R-Mutura/the_hub/README.md

# the_hub
intricate design with USB hub PD charger and M.2 connector
