R-Mutura/the_hub/BOM/BOM.xlsx

REFERENCE | VALUE | FOOTPRINT | MANUFUCTURER PART NO | VENDOR | LINKS | QTY | PRICE/ PIECE | TOTAL
> C1-C7, C20-C22, C25, C26, C28-C30, C32, C33, C45-C48, C54, C55, C58-C64, C67, C68, C70, C72-C76, C93-C95, C102-C114, C120-C123, C129-C133, C135-C155, C189, C194, C196, C197, C201 | 0.1uF | Capacitor_SMD:C_0402_1005Metric | 0402B104K6R3CT | LCSC |  | 89 | 0.0017 | 0.1513
> C8-C11, C13, C15, C17, C19, C34, C35, C56, C192, C193, C202 | 10uF | Capacitor_SMD:C_0603_1608Metric | CL10A106MQ8NNNC | LCSC |  | 14 | 0.0017 | 0.0238
C161 | 10uF | Capacitor_SMD:C_0603_1608Metric | GRM188R6YA106MA73D | LCSC |  | 1 | 0.0596 | 0.0596
> C12, C14, C16, C18, C159 | 100nF | Capacitor_SMD:C_0402_1005Metric | 0402B104K6R3CT | LCSC |  | 5 | 0.0017 | 0.0085
> C23, C24, C36, C37, C52, C53, C127, C128 | 22pF | Capacitor_SMD:C_0402_1005Metric | CC0402JRNPO9BN220 | LCSC |  | 8 | 0.0017 | 0.0136
C31 | 2.2uF | Capacitor_SMD:C_0402_1005Metric | EMK105ABJ225KV-F | LCSC |  | 1 | 0.0017 | 0.0017
> C38, C39, C44, C50, C119, C125 | 4.7uF | Capacitor_SMD:C_0603_1608Metric | CL10A475KQ8NNNC | LCSC |  | 6 | 0.0017 | 0.0102
> C40, C41, C115, C116 | 18pF | Capacitor_SMD:C_0402_1005Metric | 0402CG180J500NT | LCSC |  | 4 | 0.0017 | 0.0068
> C42, C117 | 1uF_1%_0.1ohm | Capacitor_SMD:C_0603_1608Metric | CC0603JRX7R7BB105 | LCSC |  | 2 | 0.0017 | 0.0034
> C43, C118 | 1uF | Capacitor_SMD:C_0603_1608Metric | CC0603JRX7R7BB105 | LCSC |  | 2 | 0.0017
> C49, C51, C124, C126, C162 | 1nF | Capacitor_SMD:C_0402_1005Metric | 0402B102J500CT | LCSC |  | 5 | 0.0017 | 0.0085
> C57, C65, C66, C69, C71, C81, C100, C134, C163, C177, C178, C186, C187 | 1uF | Capacitor_SMD:C_0402_1005Metric | CL05A105KQ5NNNC | LCSC |  | 14 | 0.0017 | 0.0238
C184 | 1uF | Capacitor_SMD:C_0402_1005Metric | CL05A105KA5NQNC | LCSC |  | 1 | 0.0017 | 0.0017
> C77, C78 | 1nF_2KV | Capacitor_SMD:C_1206_3216Metric | 1206B102K202NT | LCSC |  | 2 | 0.0017 | 0.0034
> C80, C84 | 12pF | Capacitor_SMD:C_0402_1005Metric | 0402CG120J500NT | LCSC |  | 2 | 0.0017 | 0.0034
> C79, C82, C83, C85-C92, C96-C99 | 0.01uF | Capacitor_SMD:C_0402_1005Metric | CC0402KRX7R9BB103 | LCSC |  | 15 | 0.0017 | 0.0255
C101 | 22uF | Capacitor_SMD:C_0402_1005Metric | GRM155R60J226ME11D | LCSC |  | 1 | 0.0017 | 0.0017
> C156, C158, C160 | 1uF_GRT155C81E105KE13_402 | Capacitor_SMD:C_0402_1005Metric | CL05A105KA5NQNC | LCSC |  | 3 | 0.0017 | 0.0051
C157 | 220uF | Capacitor_SMD:CP_Elec_10x10 | UWT1H221MNL1GS | LCSC |  | 1 | 0.0017 | 0.0017
C164 | 2.2uF(1mOHM) | Capacitor_SMD:C_0402_1005Metric | C1005X5R1E225KT000E | LCSC |  | 1 | 0.0017 | 0.0017
C165 | 22nF | Capacitor_SMD:C_0402_1005Metric | C1005X5R1E225KT000E | LCSC |  | 1 | 0.0017 | 0.0017
C166 | 4.7uF | Capacitor_SMD:C_0402_1005Metric | GRM155R60J475ME87D | LCSC |  | 1 | 0.0017 | 0.0017
C167 | 15nF | Capacitor_SMD:C_0402_1005Metric | CC0402KRX7R9BB153 | LCSC |  | 1 | 0.0017 | 0.0017
C168 | 10pF | Capacitor_SMD:C_0402_1005Metric | CC0402JRNPO9BN100 | LCSC |  | 1 | 0.0017 | 0.0017
C169 | 120Pf_1mOHM | Capacitor_SMD:C_0402_1005Metric | 0402CG121J500NT | LCSC |  | 1 | 0.0017 | 0.0017
C170 | 470nF(0.mOHM) | Capacitor_SMD:C_0402_1005Metric | CL05A474KP5NNNC | LCSC |  | 1 | 0.0017 | 0.0017
> C171, C173 | 270uF(8mOHM) | Capacitor_SMD:CP_Elec_6.3x7.7 | 16SVPG270M | LCSC |  | 2 | 0.0017 | 0.0034
C172 | 10uF_1mOHM_402 | Capacitor_SMD:C_0402_1005Metric | GRM155R60G106ME44D | LCSC |  | 1 | 0.0017 | 0.0017
C174 | 56pF(1.mOHM) | Capacitor_SMD:C_0402_1005Metric | C1005C0G1H560J050BA | Digikey(DK) |  | 1 | 0.0017 | 0.0017
> C175, C198, C199, C200 | 220uF | Capacitor_SMD:CP_Elec_5x5.9 | 6SVPE220MW | LCSC |  | 4 | 0.0017 | 0.0068
C176 | 1uF_50V | Capacitor_SMD:C_0402_1005Metric | CL05A105KA5NQNC | LCSC |  | 1 | 0.0017 | 0.0017
> C179, C182 | 0.1uF_25V | Capacitor_SMD:C_0402_1005Metric | GMC04X7R104K25NT | Digikey(DK) |  | 2 | 0.0017 | 0.0034
> C180, C181 | 22uF | Capacitor_SMD:C_0805_2012Metric | CL21A226MAQNNNE | LCSC |  | 2 | 0.0017 | 0.0034
C183 | 1nF>25v | Capacitor_SMD:C_0402_1005Metric | CC0402KRX7R9BB102 | LCSC |  | 1 | 0.0017 | 0.0017
> C185, C188 | 100pF | Capacitor_SMD:C_0402_1005Metric | 0402CG101J500NT | LCSC |  | 2 | 0.0017 | 0.0034
> C190, C191 | 4.7uF | Capacitor_Tantalum_SMD:CP_EIA-3528-21_Kemet-B | CA45-B-35V-4.7UF-K | LCSC |  | 2 | 0.0017 | 0.0034
C195 | 10uF | Capacitor_SMD:C_0402_1005Metric | CL05A106MP5NUNC | LCSC |  | 1 | 0.0017 | 0.0017
> C27, C203 | 0.1uf | Capacitor_SMD:C_0402_1005Metric | 0402B104K6R3CT | LCSC |  | 2 | 0.0017 | 0.0034
> D1-D6, D10-D14, D17-D22, D33-D35 | ESD122DMXR | SamacSys_Parts_2:DMX0003A | ESD122DMXR | Mouser/lcsc |  | 20 | 0.2474 | 4.948
> D7-D9 | D | Diode_SMD:D_SOD-323 | B5817WS | LCSC |  | 3 | 0.0242 | 0.0726
D23 | SSD_COM_ON_blue | LED_SMD:LED_0603_1608Metric | 19-217/BHC-ZL1M2RY/3T | LCSC |  | 1 | 0.0173 | 0.0173
D24 | STPS30L30DJF-TR | SamacSys_Parts_2:STPS30L30DJFTR | STPS30L30DJF-TR | DigiKey(DK) |  | 1 | 1.38 | 1.38
D26 | SSB44-E3/52T | Diode_SMD:D_SMB | SSB44-E3/52T | LCSC |  | 1 | 0.3795 | 0.3795
> D25, D27, D32 | ESDA25P35 | digikey-footprints:SOD-523 | ESDA25P35 | LCSC |  | 3 | 0.3082 | 0.9246
D28 | SBR10B45P5-13 | Diode_SMD:D_PowerDI-5 | SBR10B45P5-13 | LCSC |  | 1 | 0.55 | 0.55
> D29-D31 | SMAJ30A | Diode_SMD:D_SMA | SMAJ30A | DigiKey |  | 3 | 0.07883 | 0.23649
> FB1, FB2 | Ferrite Bead | Inductor_SMD:L_0603_1608Metric | HCB1608KF-391T10 | LCSC |  | 2 | 0.0045 | 0.009
HDMI1 | HDMI-SWM-19 | OLIMEX_Connectors-FP:HDMI-SWM-19 | HDMI-019S | LCSC |  | 1 | 0.3284 | 0.3284
IC1 | TUSB2046BIRHBT | SamacSys_Parts_2:QFN50P500X500X100-33N-D | TUSB2046BIRHBT | DigiKey |  | 1 | 4.96 | 4.96
> IC2, IC3 | USB2240-AEZG-06 | SamacSys_Parts_2:QFN50P600X600X100-37N-D | USB2240-AEZG-06 | Microchip | https://www.microchipdirect.com/product/search/all/USB2240 | 2 | 2.28 | 4.56
IC4 | TPS62824ADMQR | SamacSys_Parts_2:TPS62824ADMQR | TPS62824ADMQR | DigiPart | http://www.sierraic.com/TPS62824ADMQR | 1 |  | 0
IC5 | STUSB4700YQTR | SamacSys_Parts_2:QFN50P400X400X100-25N | STUSB4700YQTR | DigiPart | https://www.hkchipsource.com/chips/stmicroelectronics/STUSB4700QTR.html | 1 |  | 0
IC6 | ADAU1961WBCPZ-R7 | SamacSys_Parts_2:QFN50P500X500X100-33N-D | ADAU1961WBCPZ-R7 | DigiPart | https://www.hkchipsource.com/chips/analog-devices/ADAU1961WBCPZ-R7.html | 1 |  | 0
J1 | USB_C_Receptacle | Connector_USB:USB_C_Receptacle_Amphenol_12401610E4-2A | U262-241N-4BV64 | LCSC |  | 1 | 0.5194 | 0.5194
> J2, J3 | USB3_A | footprints:USB_A_3.1_GCT_USB1075-XX-X-X_REVE | 901-112A105AD10100 | LCSC |  | 2 | 0.2273 | 0.4546
J4 | USB_C_Receptacle | footprints:usb_C_MOLEX_105450-0101 | U262-241N-4BV64 | LCSC |  | 1 | 0.5194 | 0.5194
J5 | Micro_SD_Card_Det | footprints:GCT_MEM2051-00-195-00-A | MEM2051-00-195-00-A | DigiKey |  | 1 | $0.69 | 0.69048
J6 | RJ45_Shielded | footprints:CONN_RJ45-8Z | DS1128-05-S8B8P | LCSC | https://lcsc.com/product-detail/Ethernet-Connectors-Modular-Connectors-span-style-background-color-ff0-RJ45-span-RJ11_CONNFLY-Elec-DS1128-05-S8B8P_C86577.html | 1 | 0.2525 | 0.2525
J7 | Bus_M.2_Socket_M | footprints:TE_1-2199119-3 | SM3ZS067U310AMR1200 | DigiKey | https://www.digikey.com/en/products/detail/jae-electronics/SM3ZS067U310AMR1200/4162221 | 1 | 1.45 | 1.45
J8 | SD_Card | footprints:3M_SD-RSMT-2-MQ-WF | SD-RSMT-2-MQ-WF | DigiKey | https://www.digikey.com/en/products/detail/3m/SD-RSMT-2-MQ-WF/1616663 | 1 | 4.2 | 4.2
J9 | AudioJack2_Ground | footprints:CUI_SJ1-3533N | SJ1-3533NG | DigiKey | https://www.digikey.com/en/products/detail/cui-devices/SJ1-3533N/738698 | 1 | 1.23 | 1.23
J10 | USB_C_Receptacle_USB2.0 | footprints:GCT_USB4105_REVA | USB4105-GF-A | DigiKey | https://www.digikey.com/en/products/detail/gct/USB4105-GF-A/11198441 | 1 | 0.51083 | 0.51083
L1 | 3.3uH | SamacSys_Parts_2:INDPM4040X200N | 0840CDMCCDS-1R0MC | DigiKey | https://www.digikey.com/en/products/detail/sumida-america-components-inc/0840CDMCCDS-1R0MC/11682076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 | 1 | 1.64 | 1.64
L2 | 1uH_5.6mOHM. | footprints:0840CDMCCDS-1R0MC | SRP3012TA-R47M | DigiKey | https://www.digikey.com/en/products/detail/bourns-inc/SRP3012TA-R47M/9350988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 | 1 | 0.5294 | 0.5294
L3 | 470nH_30m | footprints:SRP3012TA-R47M | PM4548.102NLT | DigiKey | https://www.digikey.com/en/products/detail/pulse-electronics-power/PM4548-102NLT/10814970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 | 1 | 0.528 | 0.528
L4 | 4.5uH_13.5mOHM. | footprints:PM4548.102NLT | SRP1038A-100M | DigiKey |  | 1 | 0.8607 | 0.8607
L5 | SRP1038A-100M | SamacSys_Parts_2:INDPM110100X400N | SRP1038A-100M | DigiKey |  | 1 | 0.8607 | 0.8607
P1 | USB_C_Plug | footprints:USB_C_PLUG_GCT_USB4155-03-C_REVA | USB4155-03-C | Digikey | https://www.digikey.com/en/products/detail/gct/USB4155-03-C/14305161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 | 1 | 1.67 | 1.67
> Q1, Q2 | SI4842BDY-T1-GE3 | Package_TO_SOT_SMD:SuperSOT-8 | SI4842BDY-T1-GE3 | DigiKey | https://www.digikey.com/en/products/detail/vishay-siliconix/SI4842BDY-T1-GE3/1978857 | 2 | 2.33 | 4.66
Q3 | IRF3710ZSTRLPBF | Package_TO_SOT_THT:TO-220-3_Vertical | IRF3710ZSTRLPBF | DigiKey | https://www.digikey.com/en/products/detail/infineon-technologies/IRF3710ZSTRLPBF/1928270 | 1 | 1.95 | 1.95
Q4 | STL6P3LLH6 | footprints:TRANS_STL6P3LLH6 | STL6P3LLH6 | DigiPart | https://www.digipart.com/rfq?distr=Semisource&mfr=STM&mpn=STL6P3LLH6 | 1 |  | 0
> Q5, Q6, Q8, Q9 | BSH105,215 | Package_TO_SOT_SMD:SC-59 | BSH105,215 | LCSC | https://lcsc.com/product-detail/MOSFETs_Nexperia-BSH105-215_C478010.html | 4 | 0.21 | 0.84
Q7 | RQ5E025ATTCL | SamacSys_Parts_2:SOT95P280X100-3N | RQ5E025ATTCL | DigiKey | https://www.digikey.com/en/products/detail/rohm-semiconductor/RQ5E025ATTCL/6573259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 | 1 | 0.46 | 0.46
> R1, R21, R41 | 1K | Resistor_SMD:R_0402_1005Metric | 0402WGF1001TCE | LCSC |  | 3 | 0.0007 | 0.0021
> R2, R3, R15, R36 | 1M | Resistor_SMD:R_0402_1005Metric | 0402WGF1004TCE | LCSC |  | 4 | 0.0007 | 0.0028
> R4-R7 | 6.8K | Resistor_SMD:R_0603_1608Metric | 0402WGJ0222TCE | LCSC |  | 4 | 0.0006 | 0.0024
R8 | 2.2K_402 | Resistor_SMD:R_0402_1005Metric | 0402WGJ0222TCE | LCSC |  | 1 | 0.0025 | 0.0025
R9 | 100K | Resistor_SMD:R_0805_2012Metric | 0805W8F1003T5E | LCSC |  | 1 | 0.0242 | 0.0242
R10 | 249OHM/1% | Resistor_SMD:R_0603_1608Metric | ARG03BTC2489 | LCSC |  | 1 | 0.0242 | 0.0242
> R11-R13, R31-R35, R101 | 4.7K | Resistor_SMD:R_0402_1005Metric | 0402WGF4701TCE | LCSC |  | 9 | 0.0007 | 0.0063
> R14, R18-R20, R23, R39, R40, R42-R46, R50, R56, R98, R99 | 10K | Resistor_SMD:R_0402_1005Metric | 0402WGF1002TCE | LCSC |  | 16 | 0.0007 | 0.0112
> R16, R37, R79-R81, R84, R89, R93, R96 | 100K | Resistor_SMD:R_0402_1005Metric | 0402WGF1003TCE | LCSC |  | 9 | 0.0007 | 0.0063
> R17, R22, R38 | 12K_1% | Resistor_SMD:R_0402_1005Metric | RTT021202FTH | LCSC |  | 3 | 0.0026 | 0.0078
R24 | 2K_1% | Resistor_SMD:R_0402_1005Metric | AC0402FR-072KL | LCSC |  | 1 | 0.0011 | 0.0011
> R25-R28 | 75 | Resistor_SMD:R_0402_1005Metric | ERJPA2J750X | LCSC |  | 4 | 0.0167 | 0.0668
R29 | 90.9K | Resistor_SMD:R_0402_1005Metric | 0402WGF9092TCE | LCSC |  | 1 | 0.0007 | 0.0007
R30 | 10K_1% | Resistor_SMD:R_0402_1005Metric | 0402WGF1002TCE | LCSC |  | 1 | 0.0007 | 0.0007
> R47, R48 | 200K | Resistor_SMD:R_0402_1005Metric | 0402WGF2003TCE | LCSC |  | 2 | 0.0007 | 0.0014
> R49, R51-R55 | 47K | Resistor_SMD:R_0402_1005Metric | RC0402FR-0747KL | LCSC |  | 6 | 0.0025 | 0.015
R57 | 12K | Resistor_SMD:R_0402_1005Metric | RTT021202FTH | LCSC |  | 1 | 0.0026 | 0.0026
R58 | 2.55K | Resistor_SMD:R_0603_1608Metric | RMC060325.5K1%N | LCSC |  | 1 | 0.0019 | 0.0019
R59 | 26.7K | Resistor_SMD:R_0603_1608Metric | 0603WAF2672T5E | LCSC |  | 1 | 0.0015 | 0.0015
R61 | 1.24K | Resistor_SMD:R_0603_1608Metric | 0603WAF1241T5E | LCSC |  | 1 | 0.0015 | 0.0015
R62 | 100 | Resistor_SMD:R_0603_1608Metric | MR06X1000FTL | LCSC |  | 1 | 0.0014 | 0.0014
> R63, R71, R75 | 1K | Resistor_SMD:R_0603_1608Metric | 0603WAF1001T5E | LCSC |  | 3 | 0.0012 | 0.0036
R64 | 2.94K | Resistor_SMD:R_0603_1608Metric | 0603WAF2941T5E | LCSC |  | 1 | 0.0016 | 0.0016
R65 | 6m | Resistor_SMD:R_0805_2012Metric | WSLP08056L000FEA18 | DigiKey |  | 1 | 1.03 | 1.03
R66 | 82.5K | Resistor_SMD:R_0603_1608Metric | CRCW060382K5FKEA | LCSC |  | 1 | 0.007 | 0.007
> R60, R67, R72, R76 | 100K | Resistor_SMD:R_0603_1608Metric | 0603WAJ0104T5E | LCSC |  | 4 | 0.0011 | 0.0044
R102 | 36.1K | Resistor_SMD:R_0603_1608Metric | TNPW040236K1BEED | DigiKey |  | 1 | 0.59 | 0.59
R68 | 10.2K | Resistor_SMD:R_0603_1608Metric | CR0603FA1022G | LCSC |  | 1 | 0.001 | 0.001
> R69, R87, R94 | 10K | Resistor_SMD:R_0603_1608Metric | 0603WAF1002T5E | LCSC |  | 3 | 0.0013 | 0.0039
R70 | 470 | Resistor_SMD:R_0603_1608Metric | HPCR0603F470RK9 | LCSC |  | 1 | 0.0335 | 0.0335
> R73, R74 | 22K | Resistor_SMD:R_0603_1608Metric | ERJP03J223V | LCSC |  | 2 | 0.0295 | 0.059
R77 | 11K | Resistor_SMD:R_0603_1608Metric | RTT031102FTP | LCSC |  | 1 | 0.0013 | 0.0013
R78 | 47.5K | Resistor_SMD:R_0603_1608Metric | 0603WAF4752T5E | LCSC |  | 1 | 0.0014 | 0.0014
R82 | 270 | Resistor_SMD:R_0603_1608Metric | HPCR0603F270RK9 | LCSC |  | 1 | 0.0382 | 0.0382
R83 | 9.53K | Resistor_SMD:R_0603_1608Metric | 0603WAF9531T5E | LCSC |  | 1 | 0.0013 | 0.0013
R85 | 30K | Resistor_SMD:R_0603_1608Metric | 0603WAF3002T5E | LCSC |  | 1 | 0.0013 | 0.0013
R86 | 8.87K_603 | Resistor_SMD:R_0603_1608Metric | ERJ-3EKF3651V | DigiKey |  | 1 | 0.1 | 0.1
R88 | 2.2K | Resistor_SMD:R_0603_1608Metric | RC0603FR-103KL | LCSC |  | 1 | 0.0015 | 0.0015
R90 | 3K_603 | Resistor_SMD:R_0603_1608Metric | RC0603FR-103KL | DigiKey |  | 1 | 0.1 | 0.1
R91 | 2.4K_603 | Resistor_SMD:R_0603_1608Metric | SDR03EZPF2401 | DigiKey |  | 1 | 0.15 | 0.15
R92 | 820 | Resistor_SMD:R_0603_1608Metric | CR0603FA8200G | LCSC |  | 1 | 0.0008 | 0.0008
R95 | 3.65K_603 | Resistor_SMD:R_0603_1608Metric | RMCF0603FT3K65 | DigiKey |  | 1 | 0.1 | 0.1
R97 | 2.2K_805 | Resistor_SMD:R_0603_1608Metric | RC0805FR-132K2L | DigiKey |  | 1 | 0.1 | 0.1
R100 | 49.9 | Resistor_SMD:R_0402_1005Metric | 0402WGF499JTCE | LCSC |  | 1 | 0.0007 | 0.0007
Ron1 | 65.4K | Resistor_SMD:R_0805_2012Metric | RMCF0805FT6K65 | DigiKey |  | 1 | 0.1 | 0.1
T1 | H5008FNL | SamacSys_Parts_2:H5008FNL | H5008FNL | DigiKey |  | 1 | 11.4 | 11.4
U1 | HD3SS460 | footprints:QFN40P450X250X80-31N120X320 | HD3SS460 | DigiKey |  | 1 | 2.02248 | 2.02248
> U2-U5 | SY6280 | Package_TO_SOT_SMD:SOT-23-5 | SY6280AAAC | LCSC |  | 4 | 0.2069 | 0.8276
U6 | MCDP2900 | footprints:BGA64C100P8X8_1000X800X120N | MCDP2900 | DigiKey |  | 1 | 11.59 | 11.59
U7 | ZLDO1117G12TA | Package_TO_SOT_SMD:SOT-223-3_TabPin2 | ZLDO1117G12TA | LCSC |  | 1 | 0.3611 | 0.3611
U8 | LAN7850 | footprints:QFN40P700X700X100-57N | LAN7850 | DigiPart | https://www.digipart.com/rfq?distr=Gupan&mfr=Microchip%20Technology&mpn=LAN7850/8JX | 1 |  | 0
U9 | TUSB9261 | footprints:QFP40P900X900X120-65N | TUSB9261 | DigiKey |  | 1 | 6.41 | 6.41
U10 | USB7206 | footprints:QFN40P1200X1200X90-101N | USB7206 | DigiPart | https://www.digipart.com/part/USB7206 | 1 |  | 0
U11 | LM3478MM_NOPB | digikey-footprints:TSSOP-8_W3mm | LM3478MM_NOPB | DigiPart | https://www.utsource.net/itm/p/822983.html?digipart=1 | 1 | 3.97 | 3.97
U12 | LM3150MH | Package_SO:HTSSOP-14-1EP_4.4x5mm_P0.65mm_EP3.4x5mm_Mask3x3.1mm | LM3150MHX/NOPB | LCSC |  | 1 | 2.71 | 2.71
U13 | STUSB4500QTR | Package_DFN_QFN:QFN-24-1EP_4x4mm_P0.5mm_EP2.7x2.7mm | STUSB4500QTR | DigiPart | https://www.digipart.com/rfq?distr=Ztztech&mfr=STMicroelectronics&mpn=STUSB4500QTR | 1 |  | 0
U14 | LM3489QMM | footprints:SOP65P490X110-8N | LM3489QMM/NOPB | DigiKey |  | 1 | 1.93 | 1.93
U15 | CWDM3011P | footprints:SOIC127P600X175-8N | CWDM3011P TR13 PBFREE | DigiKey |  | 1 | 0.97 | 0.97
U16 | SQJ951EP | SamacSys_Parts_2:SQJ968EPT1GE3 | SQJ951EP-T1_BE3 | Mouser |  | 1 | 1.53 | 1.53
Y1 | 27MHz | Crystal:Crystal_HC33-U_Horizontal_1EP_style1 | ABM8G-27.000MHZ-B4Y-T | DigiKey |  | 1 | 0.82 | 0.82
Y2 | 6MHz | Crystal:Crystal_SMD_HC49-SD | AS-6.000-12-2020-EXT-SMD-TR | DigiKey |  | 1 | 0.23 | 0.23
> Y3, Y6 | 24.0MHz | Crystal:Crystal_SMD_2016-4Pin_2.0x1.6mm | ABM11-24.000MHZ-D2X-T3 | DigiKey |  | 2 | 1.19 | 2.38
> Y4, Y7 | 25MHz_402F2501XIAR | Crystal:Crystal_SMD_2016-4Pin_2.0x1.6mm | 402F2501XIAR | DigiKey |  | 2 | 0.76 | 1.52
Y5 | 40MHz | Crystal:Crystal_SMD_2520-4Pin_2.5x2.0mm | ABM10W-40.0000MHZ-8-D1X-T3 | DigiKey |  | 1 | 0.65 | 0.65
TOTAL |  |  |  |  |  |  |  | #VALUE!
