R-Mutura/the_hub/STEP/STL6P3LLH6.step

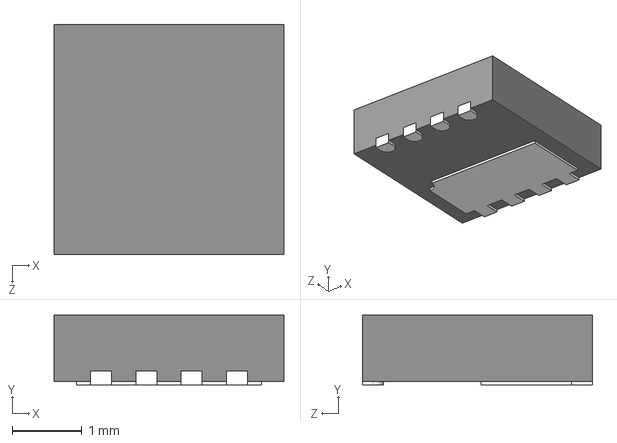
[picture p5: CAD file, 2021-10-29]
STEP/STL6P3LLH6.step
3.30 x 1 x 3.30 mm
