R-Mutura/the_hub/LOCAL_LIBS/USB4105_REVA.step

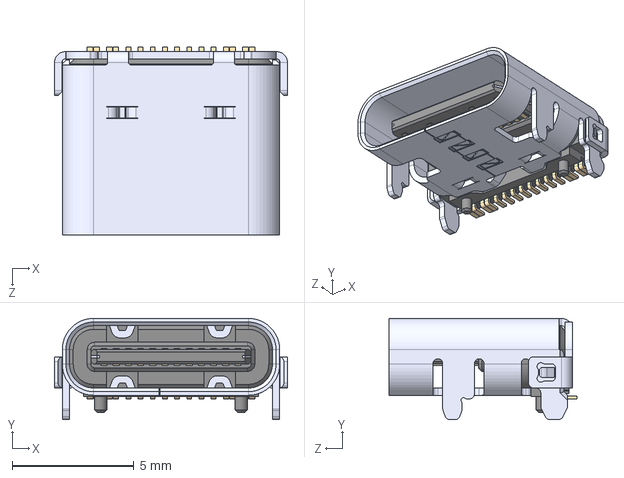
[picture p6: CAD file, 2021-10-29]
LOCAL_LIBS/USB4105_REVA.step
9.58 x 4.16 x 7.71 mm
