R-Mutura/the_hub/STEP/RJ45-8Z.step

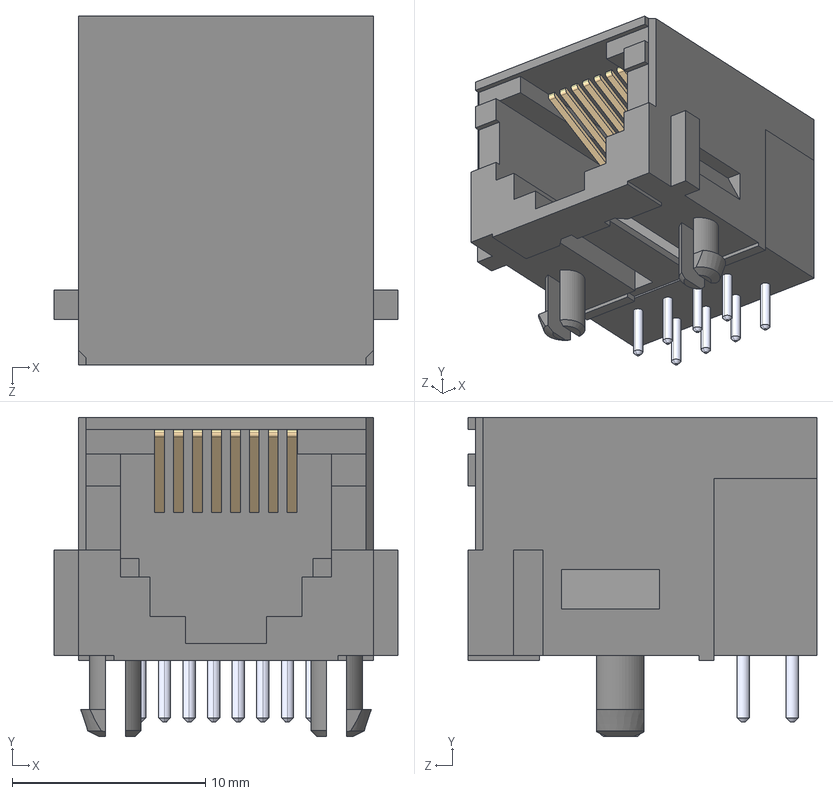
[picture p7: CAD file, 2021-10-29]
STEP/RJ45-8Z.step
17.8 x 16.5 x 18.0 mm
