R-Mutura/the_hub/STEP/SD-RSMT-2-MQ-WF.step

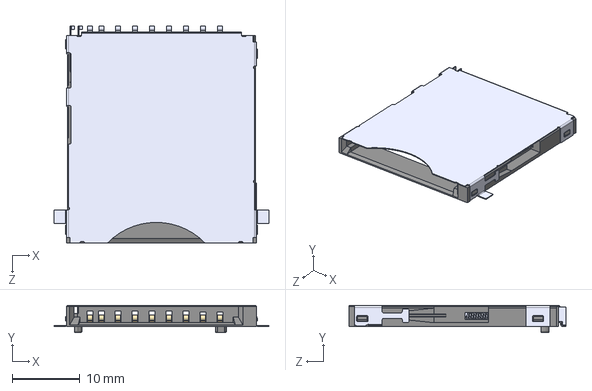
[picture p8: CAD file, 2021-10-29]
STEP/SD-RSMT-2-MQ-WF.step
31.6 x 4.00 x 31.9 mm
