R-Mutura/the_hub/STEP/LM3489MM.step

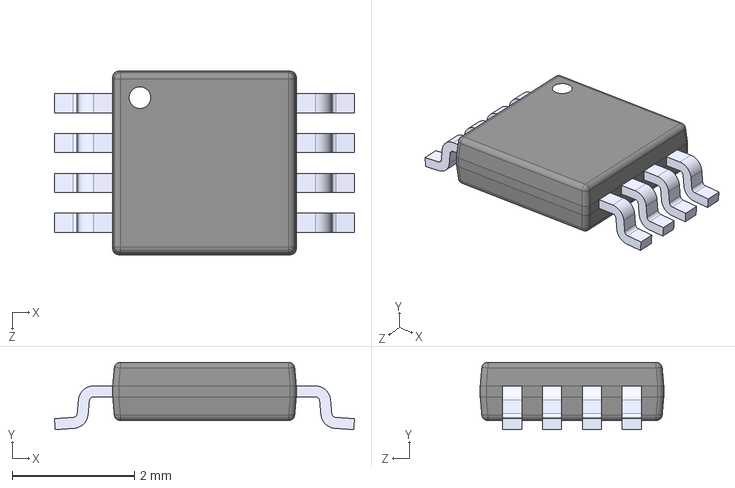
[picture p9: CAD file, 2021-10-29]
STEP/LM3489MM.step
4.90 x 1.10 x 3.00 mm
