R-Mutura/the_hub/STEP/MEM2051-00-195-00-A.step

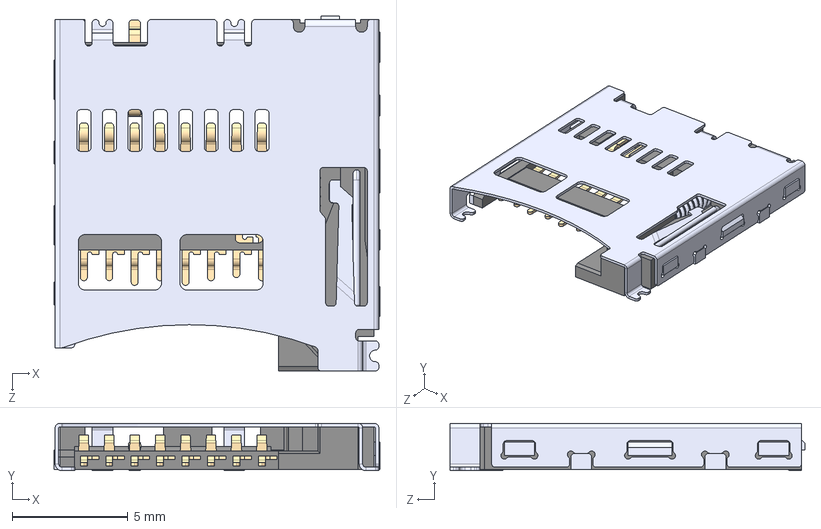
[picture p10: CAD file, 2021-10-29]
STEP/MEM2051-00-195-00-A.step
14.1 x 2.05 x 15.4 mm
