R-Mutura/the_hub/STEP/QFN40P450X250X80-31N120X320.step

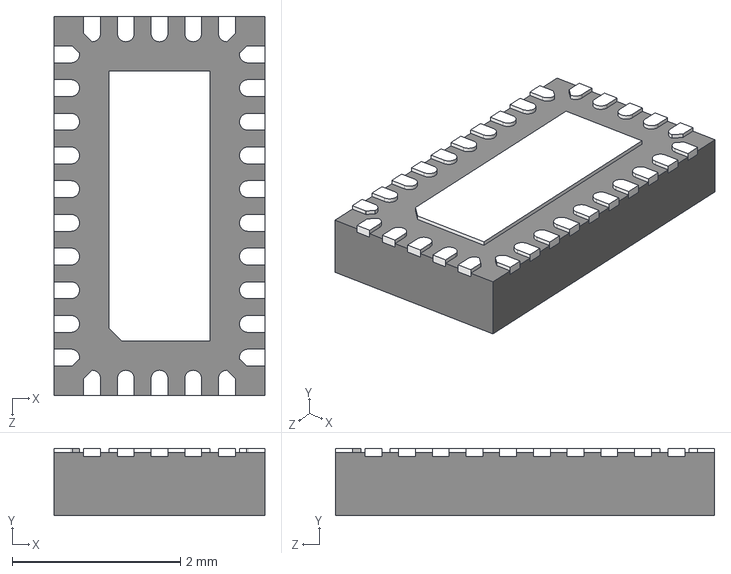
[picture p11: CAD file, 2021-10-29]
STEP/QFN40P450X250X80-31N120X320.step
2.50 x 0.8 x 4.50 mm
