R-Mutura/the_hub/STEP/1-2199119-3.step

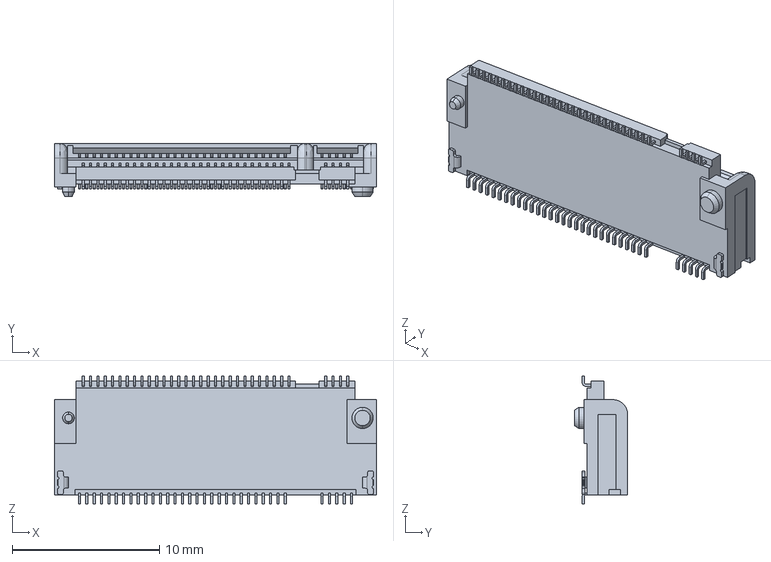
[picture p12: CAD file, 2021-10-29]
STEP/1-2199119-3.step
21.9 x 3.62 x 8.70 mm
