R-Mutura/the_hub/LOCAL_LIBS/105450-0101.step

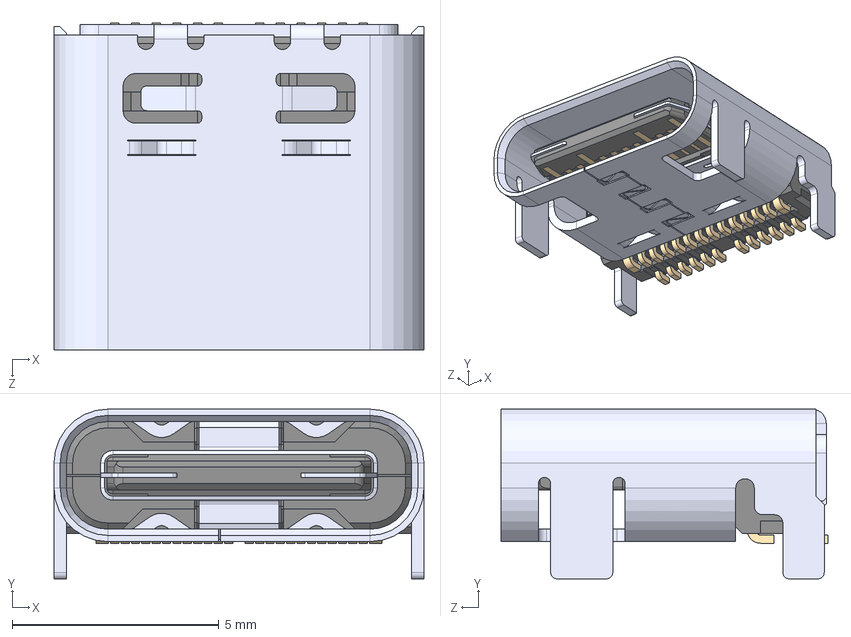
[picture p13: CAD file, 2021-10-29]
LOCAL_LIBS/105450-0101.step
8.94 x 4.10 x 7.90 mm
