R-Mutura/the_hub/LOCAL_LIBS/1932258-1.step

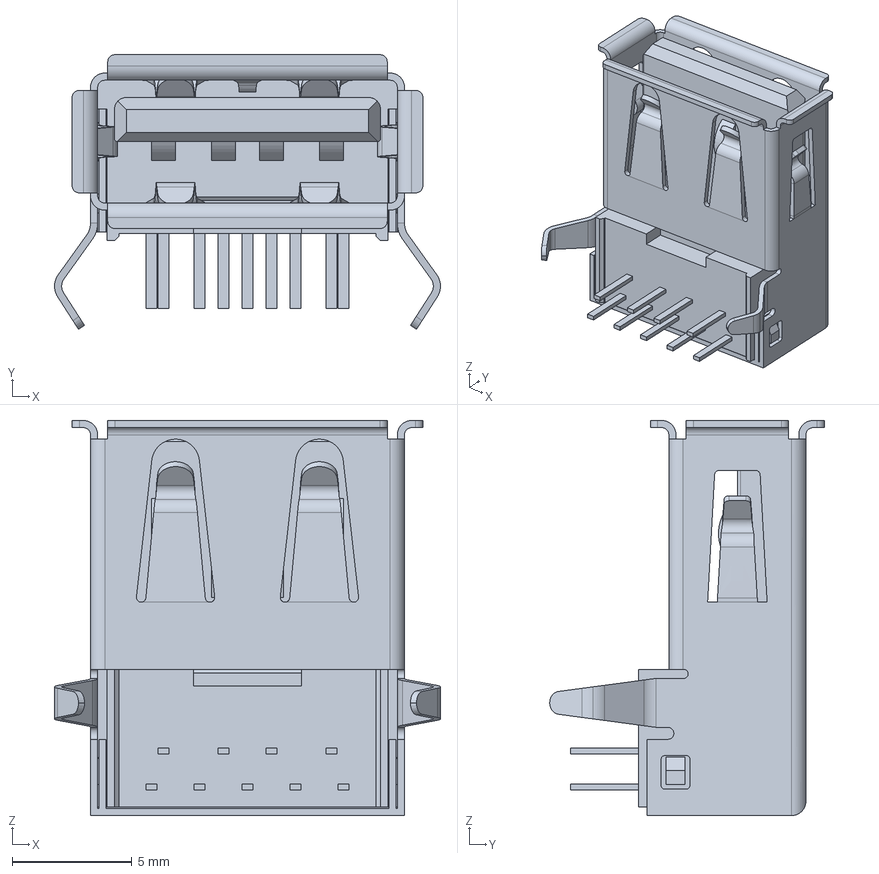
[picture p14: CAD file, 2021-10-29]
LOCAL_LIBS/1932258-1.step
16.1 x 11.5 x 16.5 mm
