R-Mutura/the_hub/(commit log)

2021-10-20 the initial commit
    [USB_C_HUB.kicad_pcb, USB_C_HUB.sch]
2021-10-23 PD controller and charging schematic complete
2021-10-23 PD controller_ power components inclusion pending
    [PD_CONTROLLER.sch, USB_C_HUB.sch]
2021-10-23 PD controller + variable voltage source input(will handle voltage requestvia PD)
    [PD_CONTROLLER.sch, USB_C_HUB.sch, Variable Voltage Source.sch]
2021-10-24 With ST PD controller(sink)100W
    [PD_CONTROLLER.sch, ST_PD CHARGING CONTROLLER.sch, UFP_PD_CTRL + VAR_V_SOURCE.sch, USB_C_HUB.sch, Variable Voltage Source.sch]
2021-10-24 With ST_PD controller, Buck $ Boost regulators
    [3V3 BUCK bom_original.csv, 3V3_BUCK.sch, 5V_BUCK.sch, USB_C_HUB.sch]
2021-10-24 usb c mux
    [USB_C_HUB.sch]
2021-10-25 usb MUX with DFPs
    [3V3_BUCK.sch, ST_PD CHARGING CONTROLLER.sch, UFP_PD_CTRL + VAR_V_SOURCE.sch, USB_C_HUB.sch, USB_HUB_CTRL.sch]
2021-10-25 commit with all DFPs properly connected
    [3V3_BUCK.sch, LAN7850 ETHERNET.sch, SD_CARD UHS II.sch, ST_PD CHARGING CONTROLLER.sch, UFP_PD_CTRL + VAR_V_SOURCE.sch, USB_C_HUB.sch, USB_HUB_CTRL.sch]
2021-10-26 all but HDMI + 2 DFP ports
    [3V3_BUCK.sch, DP TO HDMI.sch, LAN7850 ETHERNET.sch, ST_PD CHARGING CONTROLLER.sch, UFP_PD_CTRL + VAR_V_SOURCE.sch, USB TO SATA.sch, USB_C_HUB.sch, USB_HUB_CTRL.sch]
2021-10-26 all but HDMI and UFP PD
    [3V3_BUCK.sch, DP TO HDMI.sch, LAN7850 ETHERNET.sch, MICRO SD CARD.sch, ST_PD CHARGING CONTROLLER.sch, UFP_PD_CTRL + VAR_V_SOURCE.sch, USB TO SATA.sch, USB_C_HUB.sch]
2021-10-27 ALL DONE BUT THE HDMI SECTION. NEED FOOTPRINT ASSIGNMENT
    [3V3_BUCK.sch, DP TO HDMI.sch, ESD_PROTECTION.sch, LAN7850 ETHERNET.sch, MICRO SD CARD.sch, SD_CARD UHS II.sch, ST_PD CHARGING CONTROLLER.sch, UFP_PD_CTRL + VAR_V_SOURCE.sch]
2021-10-28 schematic capture complete. Pending Footprint assignment. accetable Errors=21
    [3V3_BUCK.sch, AUDIO CODEC.sch, DP TO HDMI.sch, ESD_PROTECTION.sch, LAN7850 ETHERNET.sch, MICRO SD CARD.sch, SD_CARD UHS II.sch, ST_PD CHARGING CONTROLLER.sch]
2021-10-28 schematic capture complete. Pending Footprint assignment. accetable warnings=21
    [3V3_BUCK.sch, AUDIO CODEC.sch, SD_CARD UHS II.sch, ST_PD CHARGING CONTROLLER.sch, UFP_PD_CTRL + VAR_V_SOURCE.sch, USB TO SATA.sch, USB_C_HUB.sch, USB_HUB_EXTENSION.sch]
2021-10-28 schematic capture complete. Pending FULL Footprint assignment. accetable warnings=21
    [3V3_BUCK.sch, AUDIO CODEC.sch, DP TO HDMI.sch, ESD_PROTECTION.sch, LAN7850 ETHERNET.sch, MICRO SD CARD.sch, SD_CARD UHS II.sch, ST_PD CHARGING CONTROLLER.sch]
2021-10-29 schematic capture and footprint assignment complete. Pending approval
    [1-2199119-3.step, 105450-0101.step, 1932258-1.step, 3V3_BUCK.sch, AUDIO CODEC.sch, DP TO HDMI.sch, ESD_PROTECTION.sch, LAN7850 ETHERNET.sch]
2021-10-29 schematic capture and footprint assignment complete.
2021-11-01 updated BOM, minor change in schematic
    [3V3_BUCK.sch, BOM.xlsx, DP TO HDMI.sch, USB_C_HUB.sch]
